owenvallis/chronome/Enclosure/README.rtf

Enclosure files based off of the Machine Collective design. These versions were created by Jim Murphy, and are meant to be used with a laser cutter. The enclosure will fit any Arduinome using the Bebo boards, or any Chronome board. A few notes about these files:

• Line widths need to be fixed before cutting-- just select all and specify line widths. It'll depend on where you're getting them cut.
• The colors need to be fixed -- just select all and specify stroke color (again, this depends on where you're getting them cut)
• The "this product was made with an educational version of autocad" label can be deleted in illustrator or inkscape
• Some free software to use is Inkscape -- but keep this in mind (SUPER important): It exports .svg files at a different size than what illustrator expects (it exports them at 96 dpi versus illustrator's 72 dpi)-- so the scales will be wrong if you save in Inkscape and open the .svg in illustrator. To fix this, you can scale by .85 in illustrator once it's loaded in. What I would recommend is saying fuck it and just using illustrator -- it'll make life a lot easier (and will mean that you're not running the risk of cutting things the wrong size).

Cheers,
Flipmu
