owenvallis/chronome/PCBs V2.2 Atmel Files/ChronomeV2.2/Schematic and Cad Files/ChronomeV2_2_Page_2.png

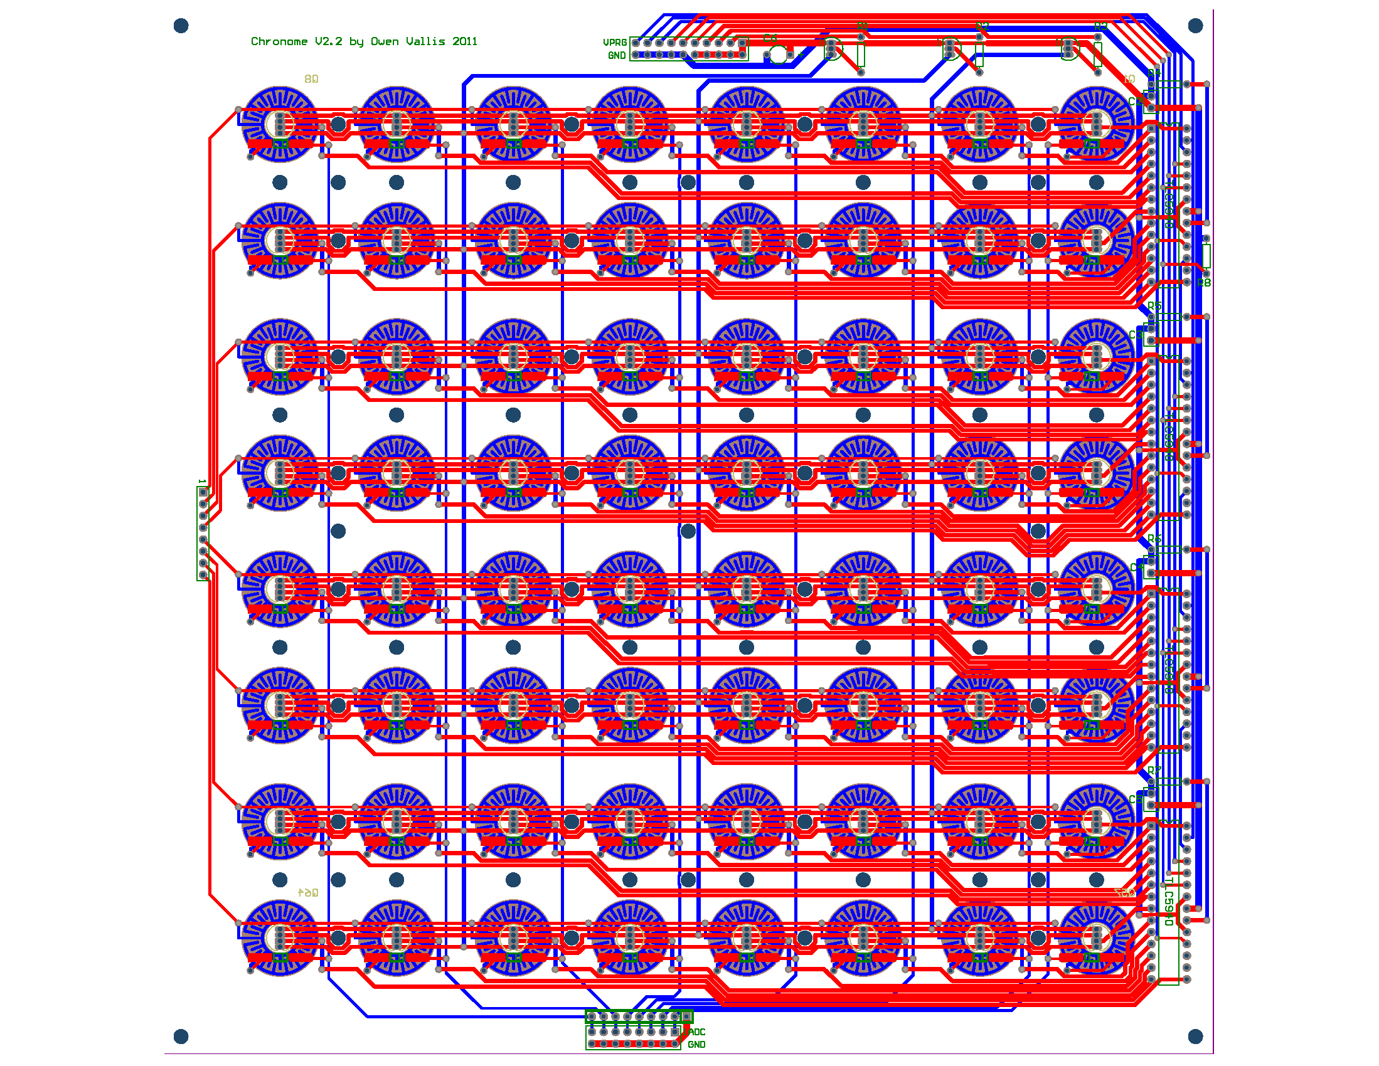
PCBs V2.2 Atmel Files/ChronomeV2.2/Schematic and Cad Files/ChronomeV2_2_Page_2.png
