owenvallis/chronome/PCBs V2.2 Atmel Files/MEGA Shield/Schematic and Cad Files/Mega Shield_Page_2.png

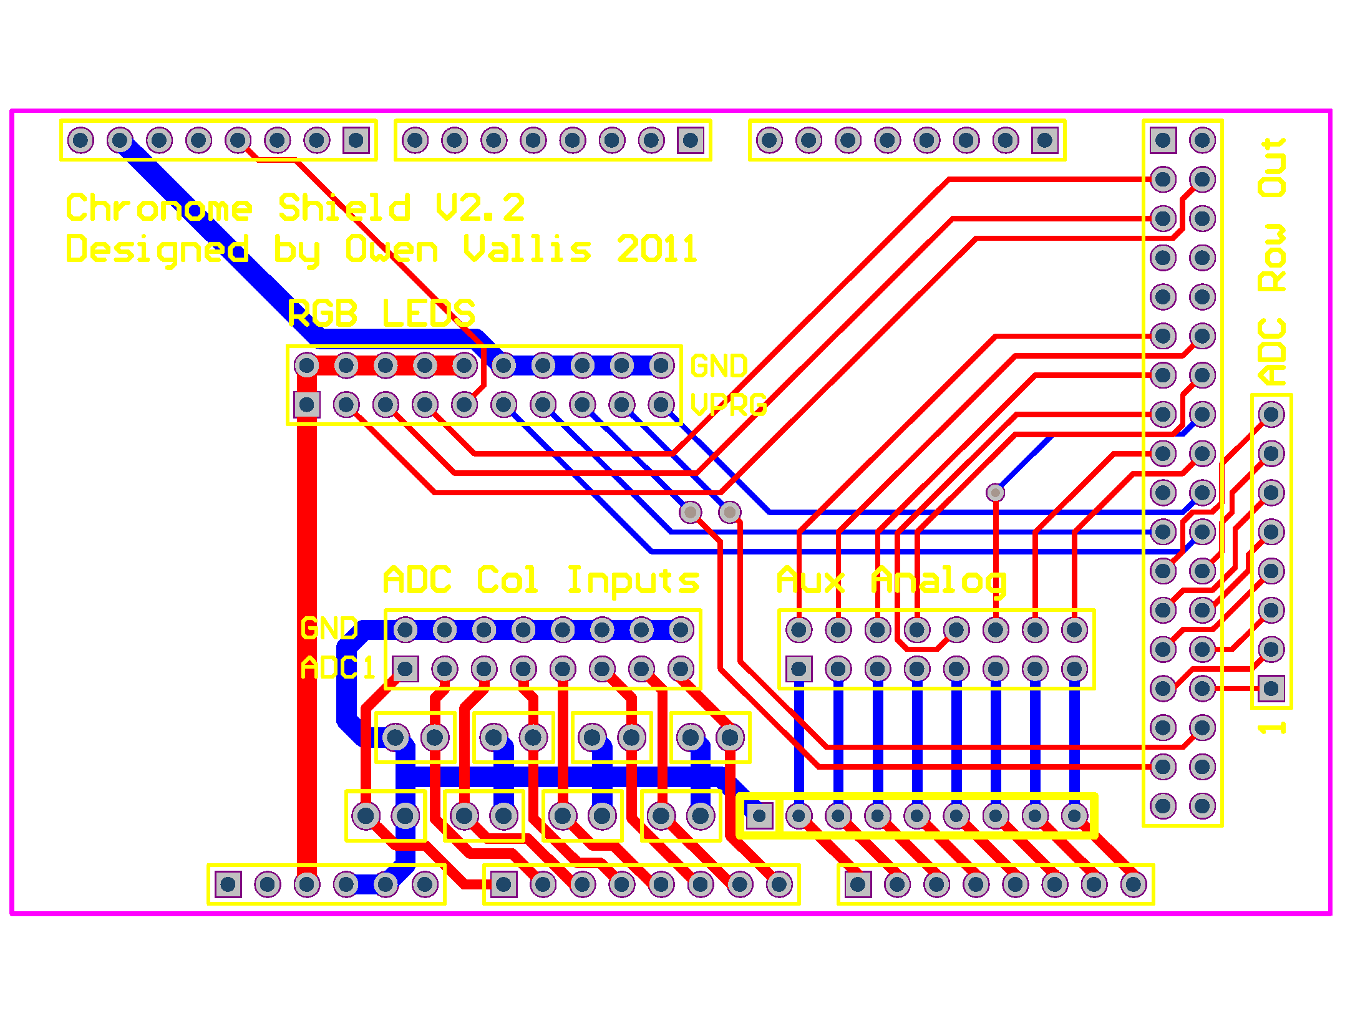
PCBs V2.2 Atmel Files/MEGA Shield/Schematic and Cad Files/Mega Shield_Page_2.png
