owenvallis/chronome/Parts BOM/Parts For Chronome.pdf

Chronome Parts List

SparkFun | | | #VALUE!
Quantity | Description | Unit Price | Total
1 | $64.95 | $64.95
4 | $9.95 | $39.80
70 | $0.14 | $9.80
1 | $59.95 | $59.95
4 | $5.95 | $23.80
4 | $1.50 | $6.00
4 | $0.25 | $1.00
5 | $2.50 | $12.50
| | Total | $217.80
Quantity | Description | Unit Price | Total
2 | $2.02 | $4.04
2 | $1.93 | $3.86
2 | $0.46 | $0.92
1 | $0.53 | $0.53
1 | $0.58 | $0.58
1 | $1.30 | $1.30
1 | $2.07 | $2.07
1 | $2.59 | $2.59
3 | $0.14 | $0.42
4 | $0.09 | $0.36
1 | $0.09 | $0.09
3 | $0.49 | $3.49
Total | $20.25
Project Total | | | $238.05

Arduino Mega Board (http://www.sparkfun.com/products/9949)
Button Pad 4x4 - LED Compatible (http://www.sparkfun.com/products/7835)
Diode Small Signal - 1N4148 (http://www.sparkfun.com/products/8588)
Triple Output LED RGB - Diffused - 100pcs (http://www.sparkfun.com/products/10017) TLC 5940 - PWM Driver (http://www.sparkfun.com/products/10136)
DIP Sockets Solder Tail - 28-Pin 0.3" (http://www.sparkfun.com/products/7942) Capacitor Ceramic 0.1uF (http://www.sparkfun.com/products/8375)
Break Away Headers - Straight (http://www.sparkfun.com/products/116)

DigiKey

CONN IDC SOCKET 20POS 15 GOLD (http://search.digikey.com/scripts/DkSearch/dksus.dll?WT.z_header=search_go&lang=en&site=us&x=0&y=0) CONN IDC SOCKET 16POS 15 GOLD (http://search.digikey.com/scripts/DkSearch/dksus.dll?WT.z_header=search_go&lang=en&site=us&x=0&y=0) CONN RECEPT 8POS 26AWG MTA100 (http://search.digikey.com/scripts/DkSearch/dksus.dll?Detail&name=A30992-ND) CAP ALUM 470UF 25V 20% RADIAL (http://search.digikey.com/us/en/products/UPW1E471MPD6/493-1827-ND/589568) RES NET 9RES 10K OHM 10PIN (http://search.digikey.com/scripts/DkSearch/dksus.dll?Detail&name=770-101-R10KP-ND) CABLE 9 COND 5' GRAY RIBBON (http://search.digikey.com/scripts/DkSearch/dksus.dll?Detail&name=AE09G-5-ND) CABLE 16 COND 5' GRAY RIBBON (http://search.digikey.com/scripts/DkSearch/dksus.dll?vendor=0&keywords=AE16G-5-) CABLE 20 COND 5' GRAY RIBBON (http://search.digikey.com/scripts/DkSearch/dksus.dll?vendor=0&keywords=AE20G-5-ND) RES 1.0K OHM CARBON FILM 1/2W 5% (http://search.digikey.com/scripts/DkSearch/dksus.dll?Detail&name=P1.0KBBCT-ND) RES 6.2K OHM CARBON FILM 1/4W 5% (http://search.digikey.com/scripts/DkSearch/dksus.dll?Detail&name=P6.2KBACT-ND) RES 10K OHM CARBON FILM 1/4W 5% (http://search.digikey.com/us/en/products/CFR-25JB-10K/10KQBK-ND/338) TRANSISTOR AMP PNP SS GP TO-92 (http://search.digikey.com/scripts/DkSearch/dksus.dll?lang=en&site=US&KeyWords=PN2907ABUFS-ND&x=0&y=0)
