owenvallis/chronome/PCBs V2.2 Atmel Files/MEGA Shield/Schematic and Cad Files/Mega Shield.pdf

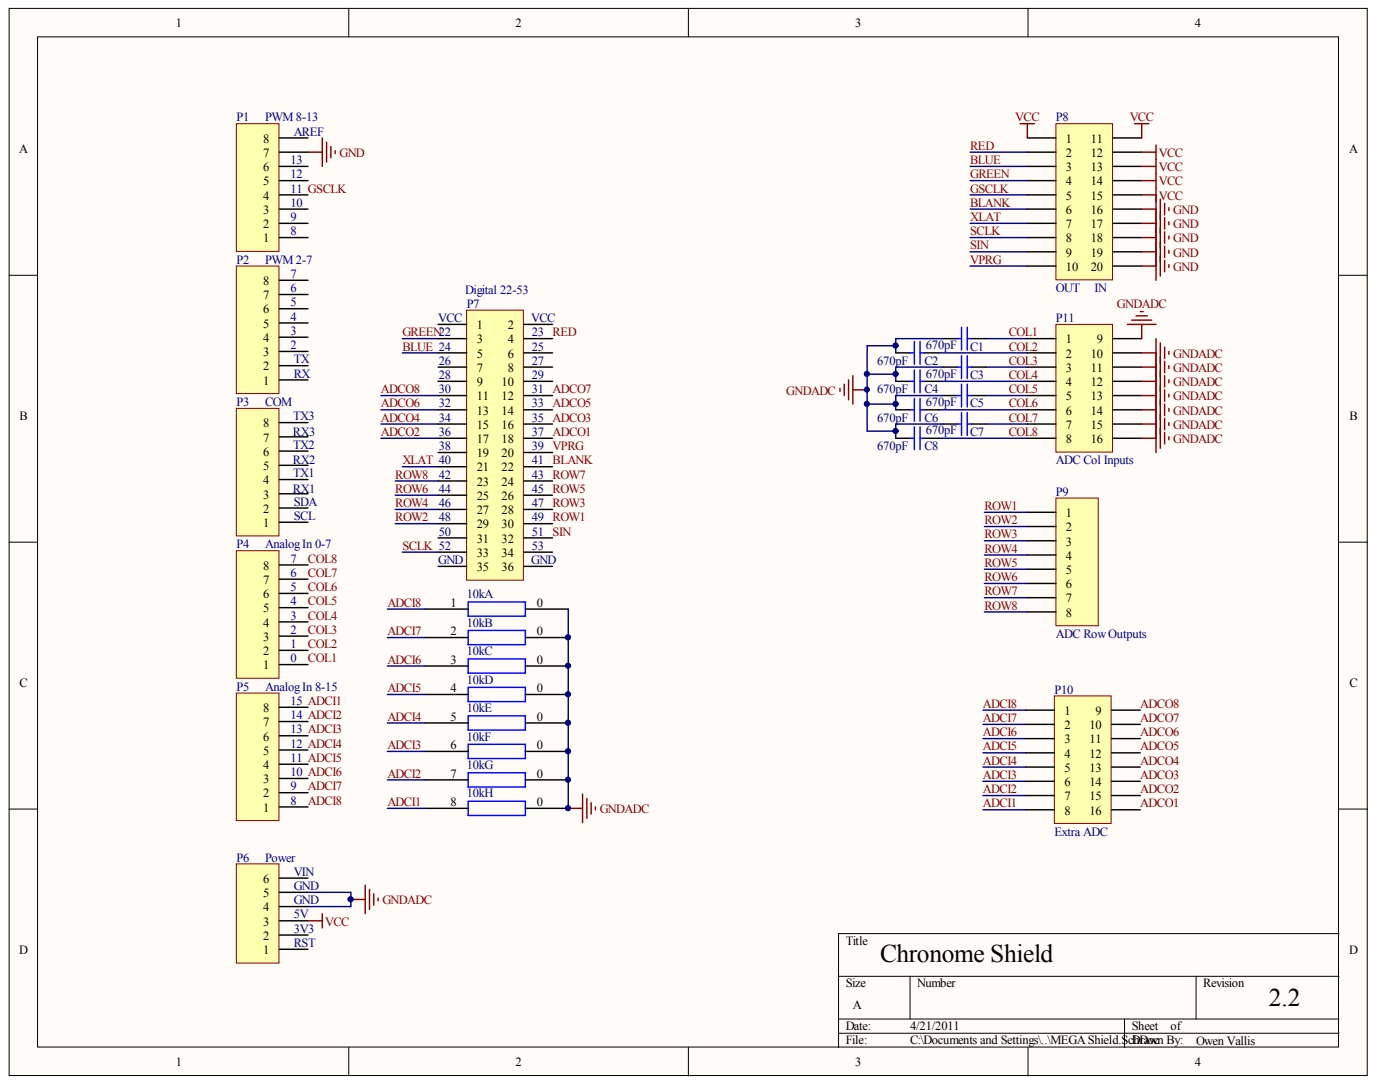
[picture p5: page 1]

LUE GREEN GSCLK BLANK XLAT SCLK SINVPRG

GND GND 5V3V3 VIN AREF 8910111213234567TXRXSCL SDA RX1 RX2 RX3 TX1 TX2 TX3
CGND

p F | C 2 | C OL 3 | | uts GNDAD

6 7 0 | p F | C 3 C OL4
p F | C 4 | | C OL 5
6 7 0 | p F | C 5 C OL 6

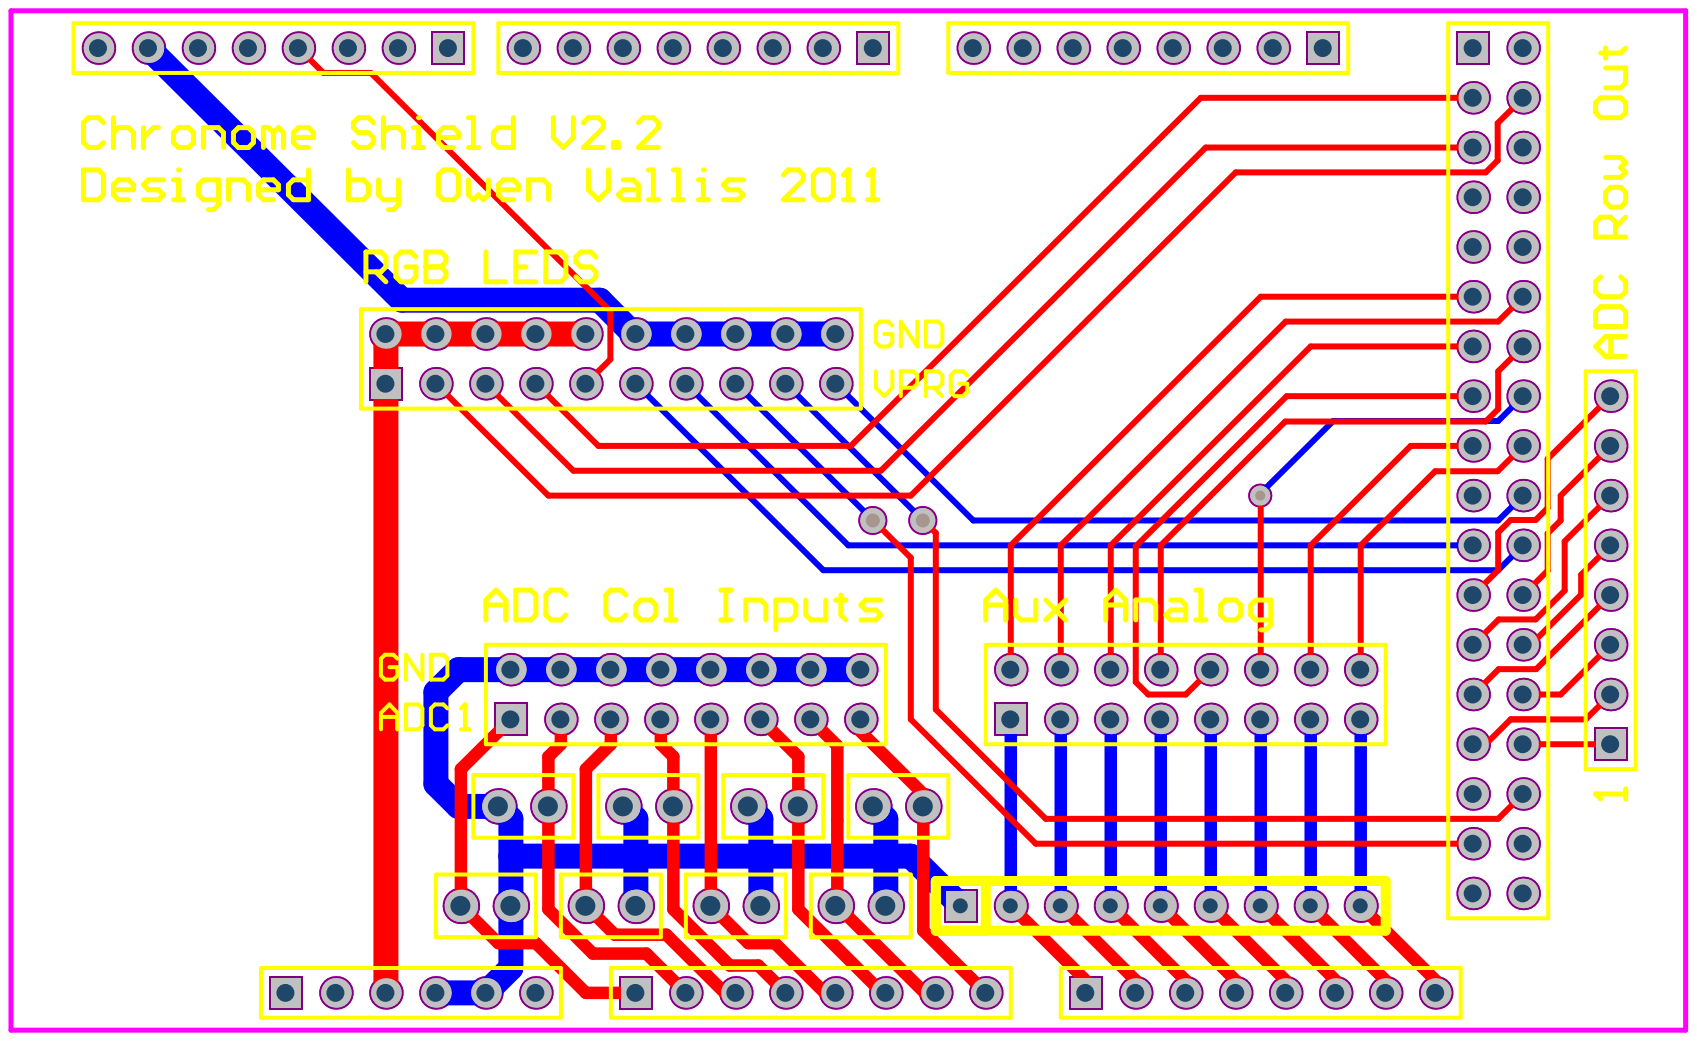
[picture p6: page 2]
