owenvallis/chronome/Button Pad Gerber Files/ChronomeV2.pdf

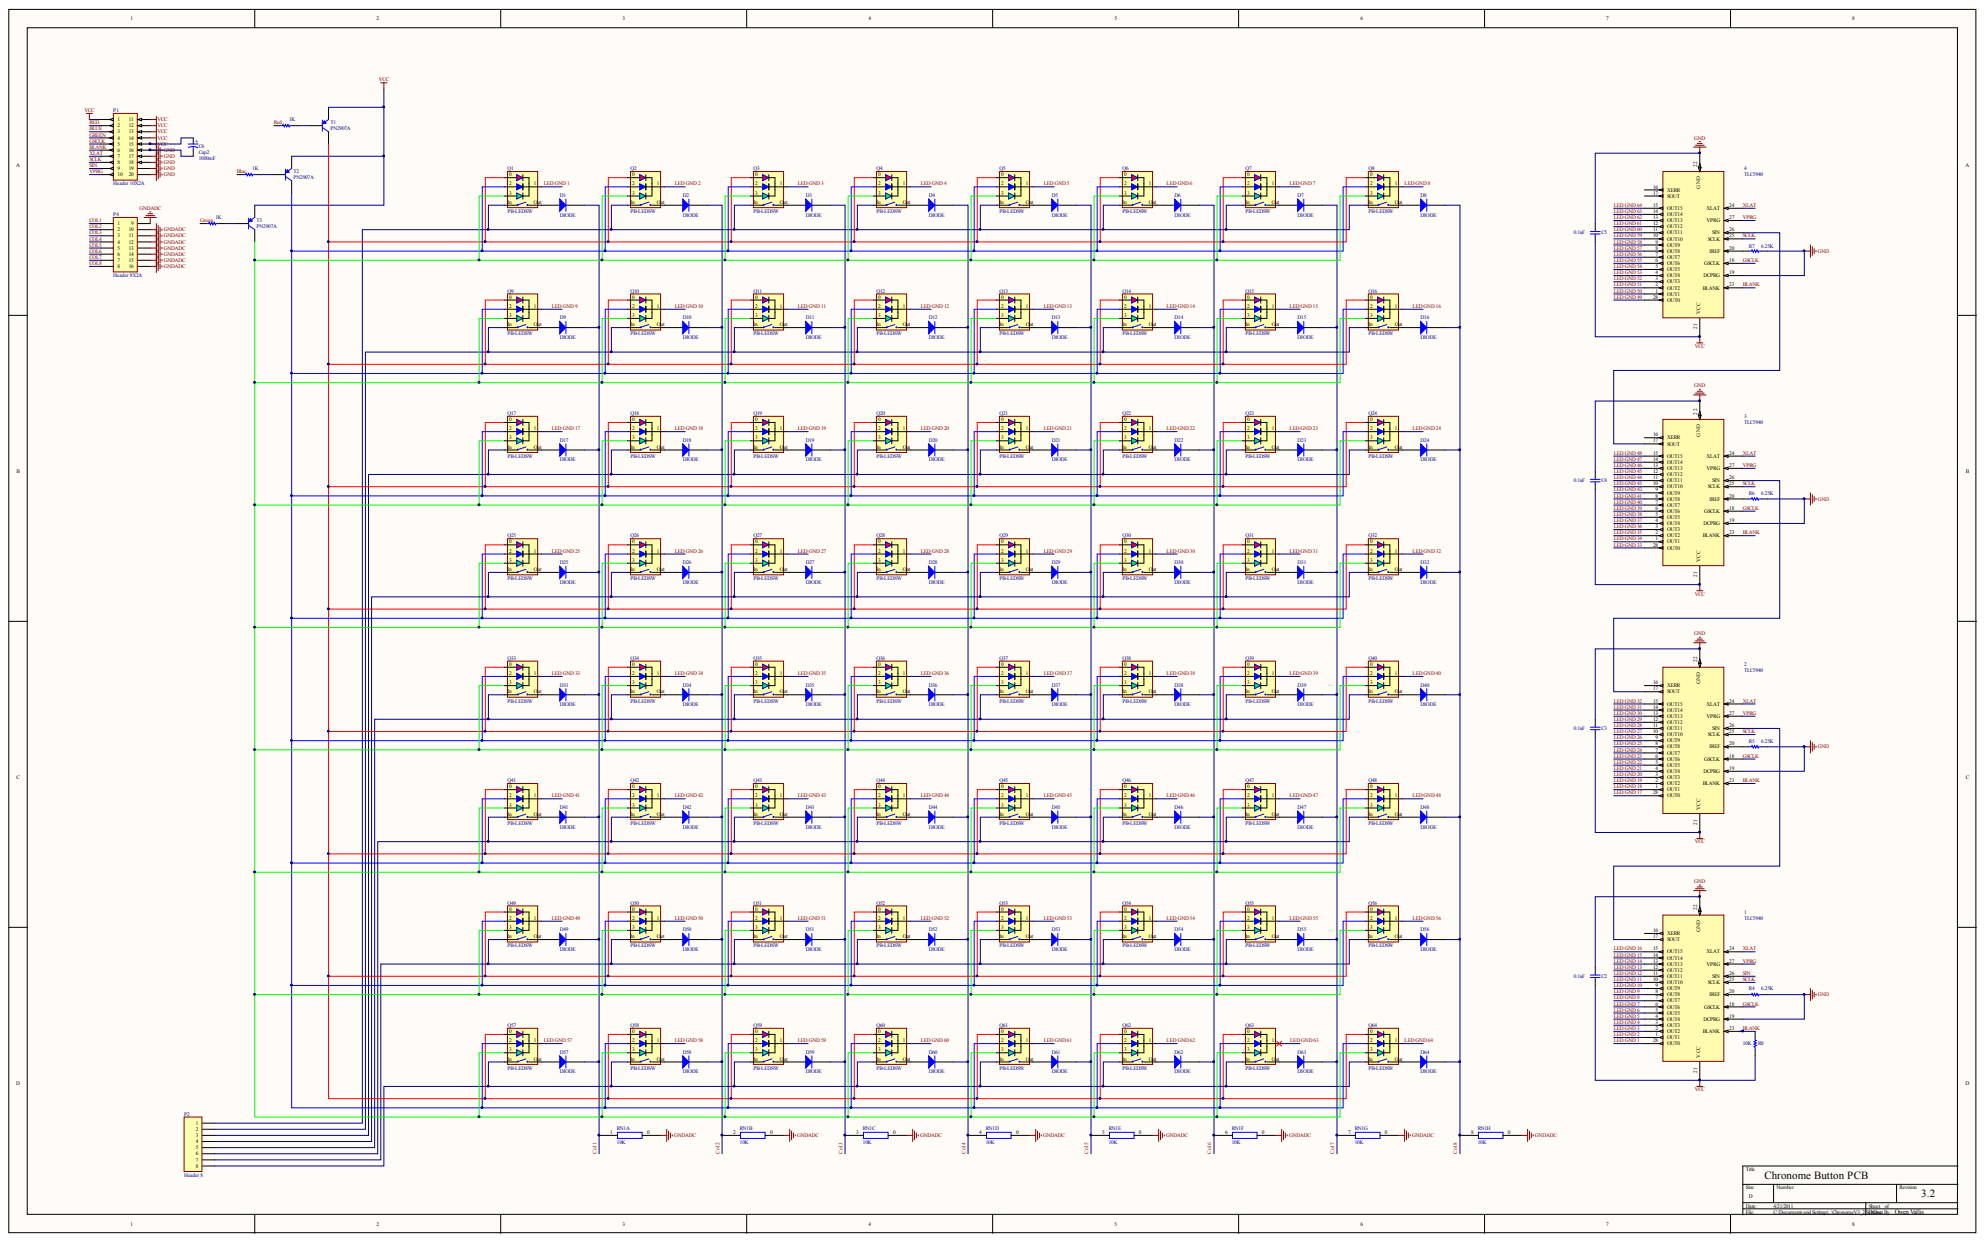
[picture p7: page 1]

RED BLUE GREEN SCLK XLAT SINGSCLK VPRG BLANK COL1 COL2 COL3 COL4 COL5 COL6 COL7 COL8

GND GND

SCLK SCLK SCLK SCLK XLAT XLAT XLAT XLAT SINGSCLK GSCLK GSCLK GSCLK R4

Size DDate | Num b e r | Re vi s i on 3. 2

: 4/2 1 /2 0 1 1 | She e t o f
Fi l e : C : \D o c um e nts a nd Se tting s\ . . \Chro nom e V 3 _2 | . ScDhraDwocn By : Owen Vallis

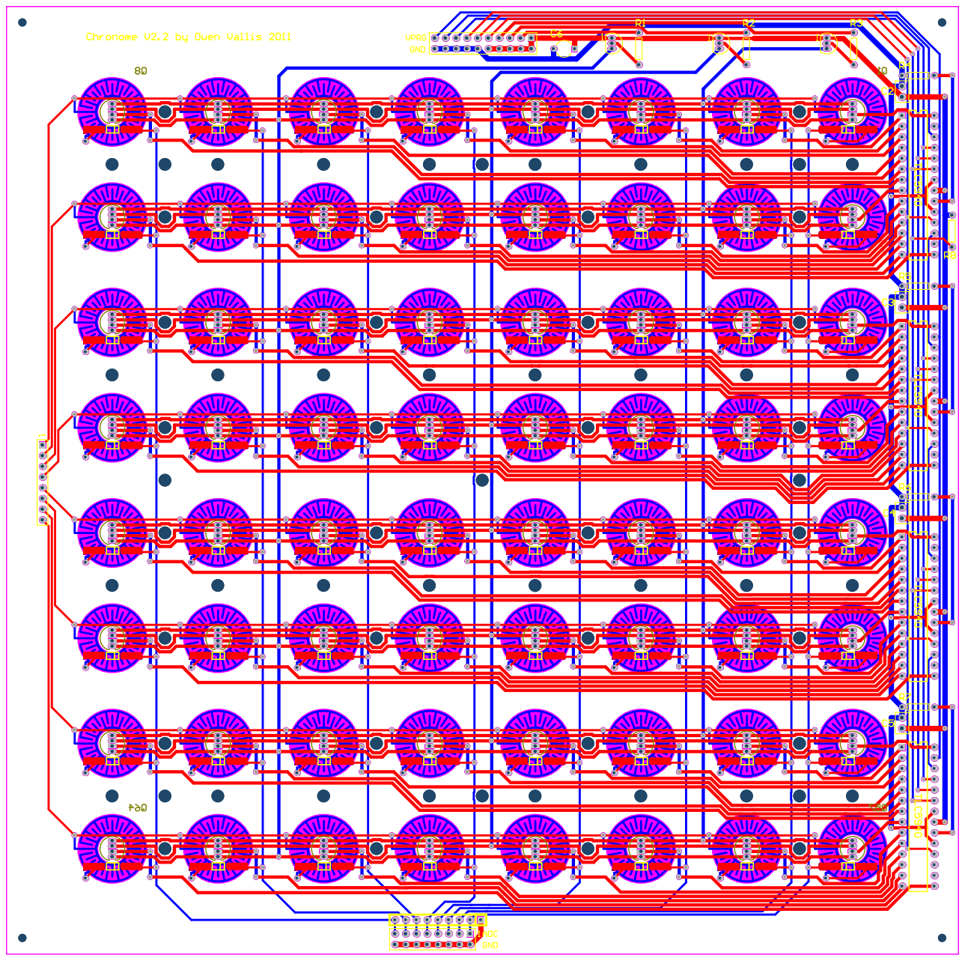
[picture p8: page 2]
