owenvallis/chronome/PCBs V2.2 Atmel Files/ChronomeV2.2/Schematic and Cad Files/ChronomeV2_2.pdf

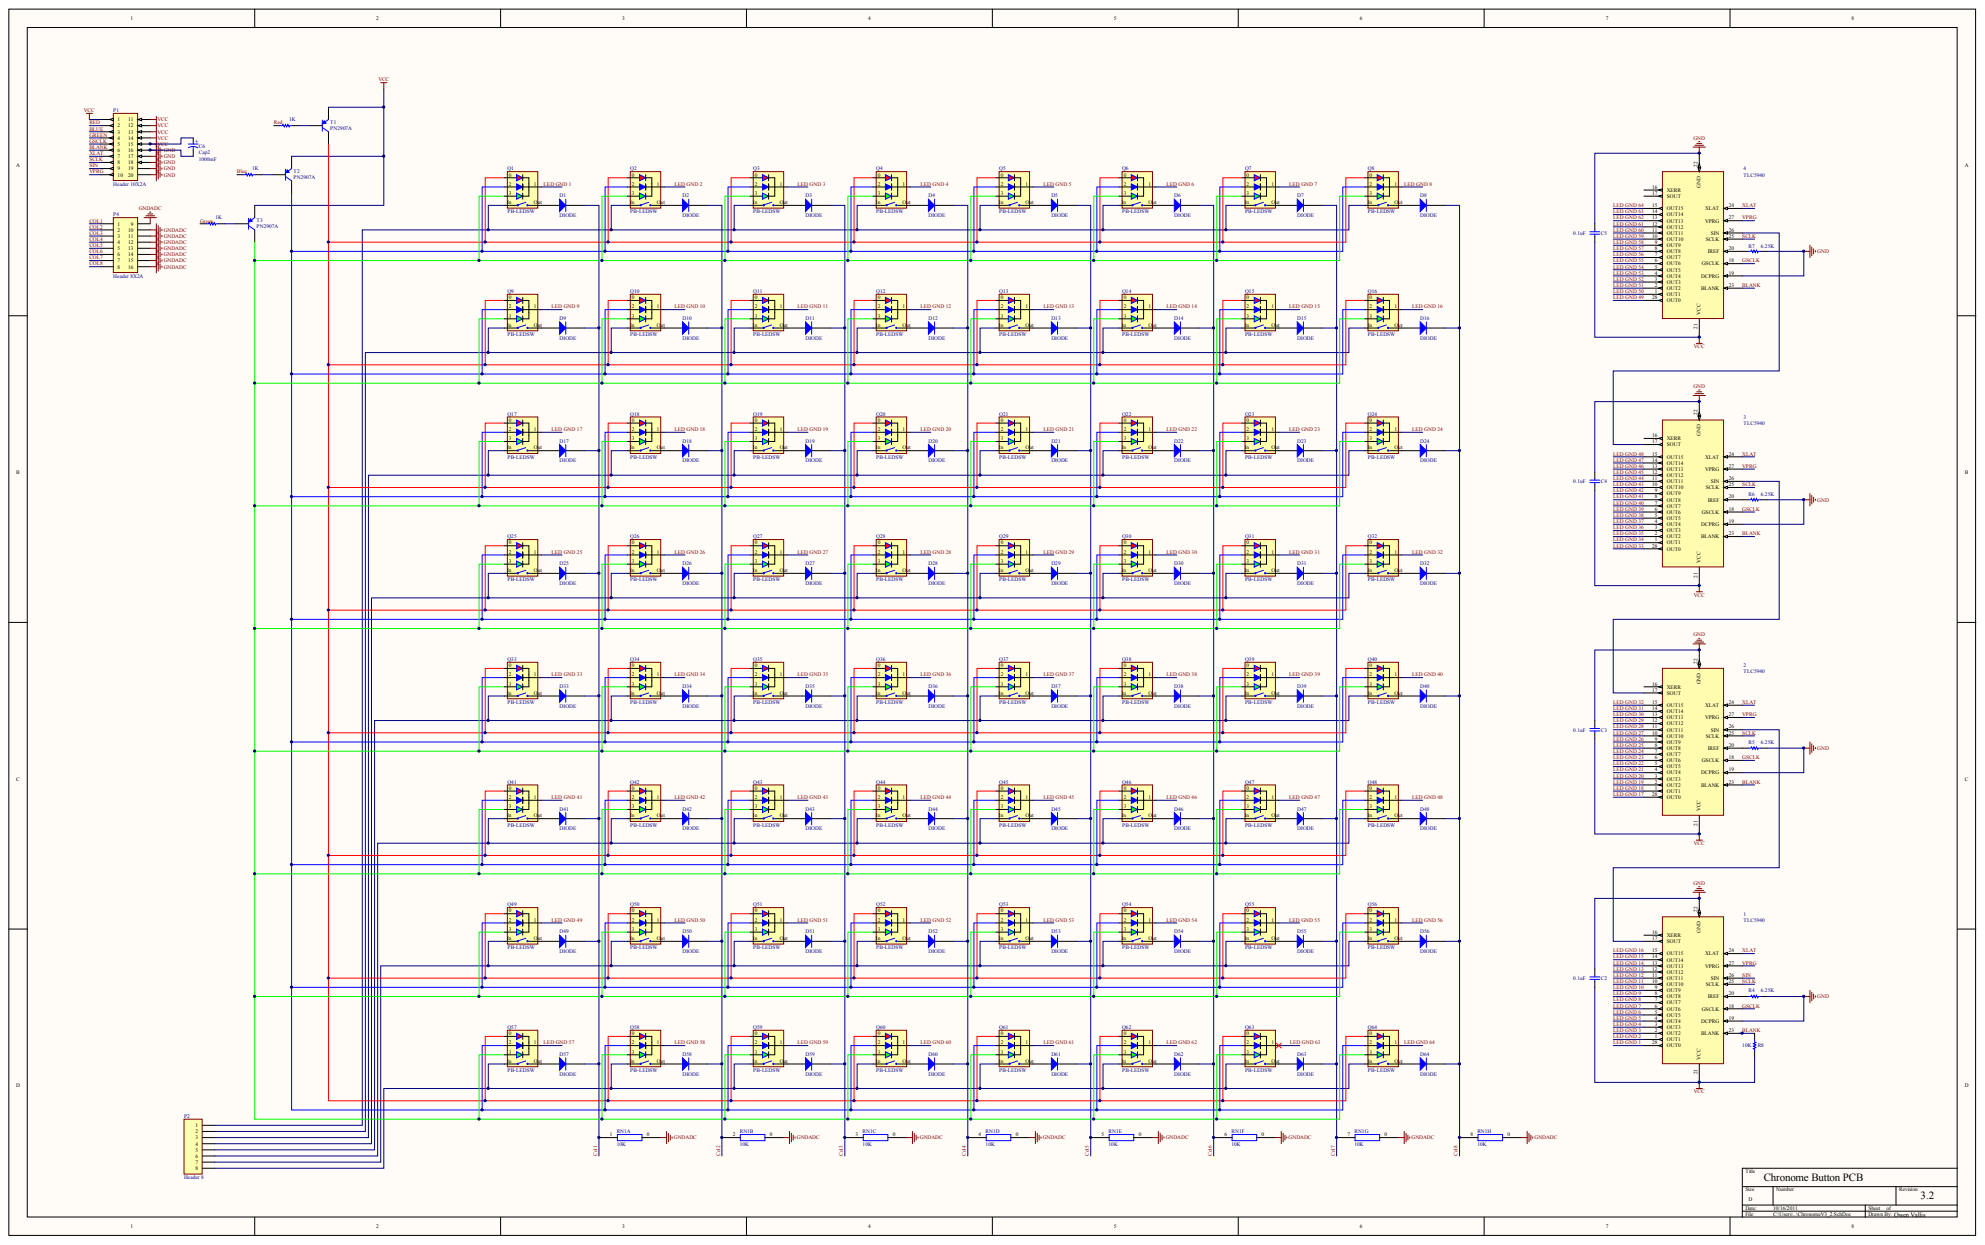
[picture p9: page 1]

VCC VCC VCC VCC VCC

XLA
VPRG VPRG

VCC VCC

Size D | Number | Rev ision 3.2

Date: 10/16/2011 | Sheet o f
Fi le: C:\Users\. .\Chronome V3_2 . SchDoc | Drawn By: O w e n V allis

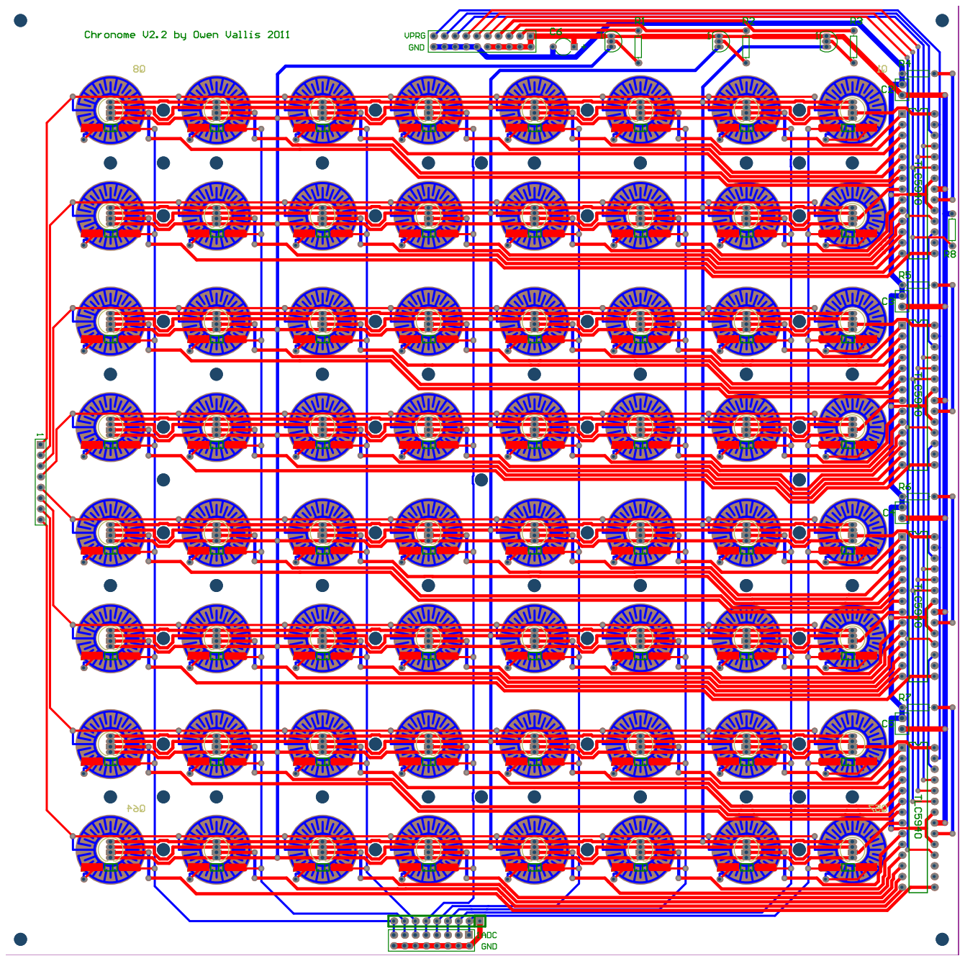
[picture p10: page 2]
