owenvallis/chronome/Enclosure/Chronome_NoWood1.pdf

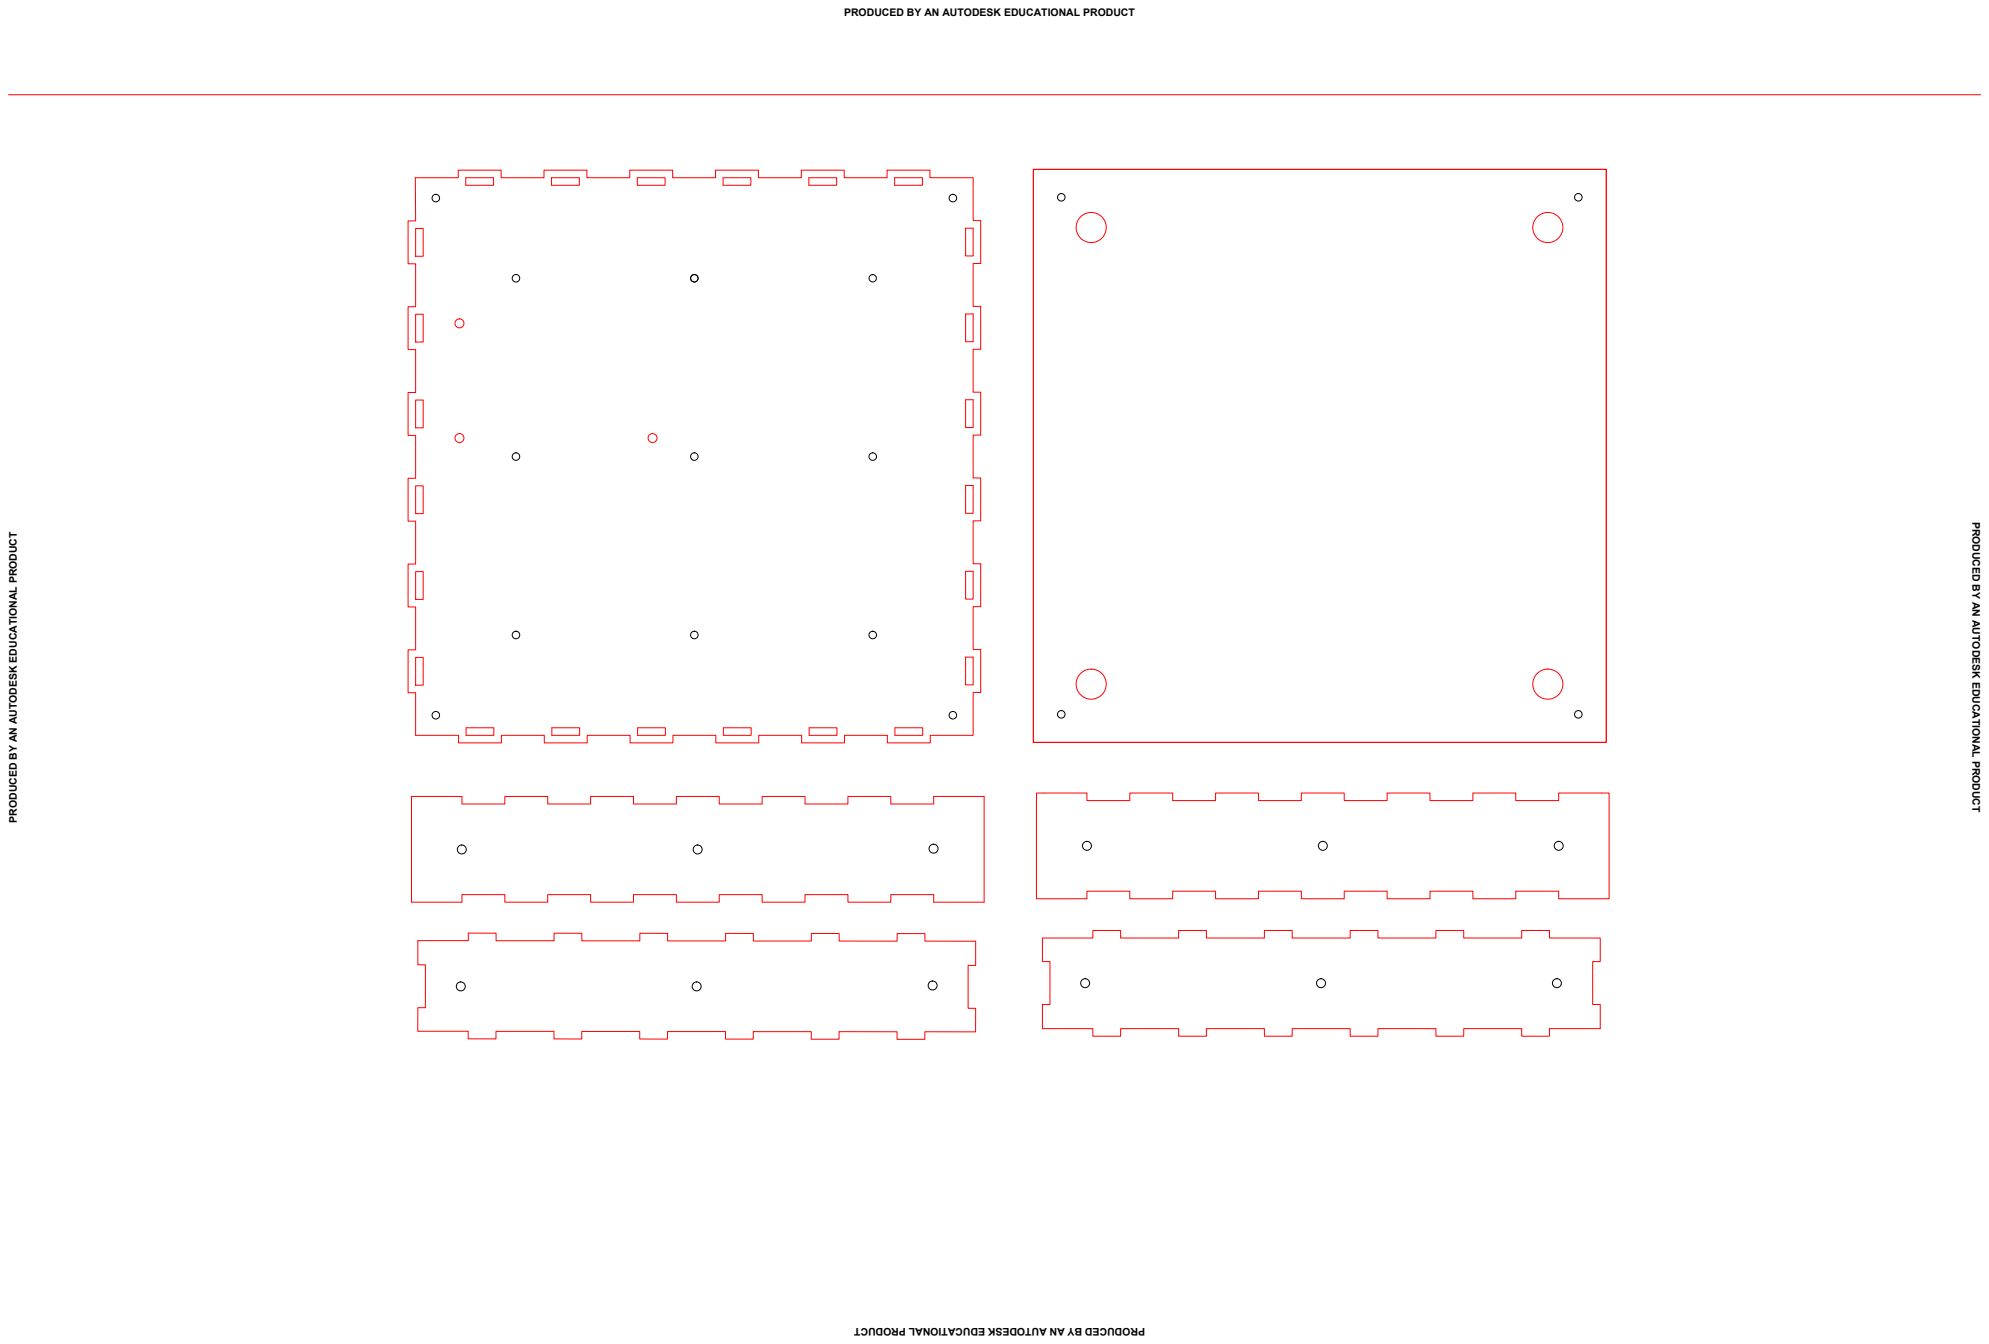
[picture p11: page 1]

PRODUCED BY AN AUTODESK EDUCATIONAL PRODUCT
