owenvallis/chronome/Enclosure/Chronome_NoWood2.pdf

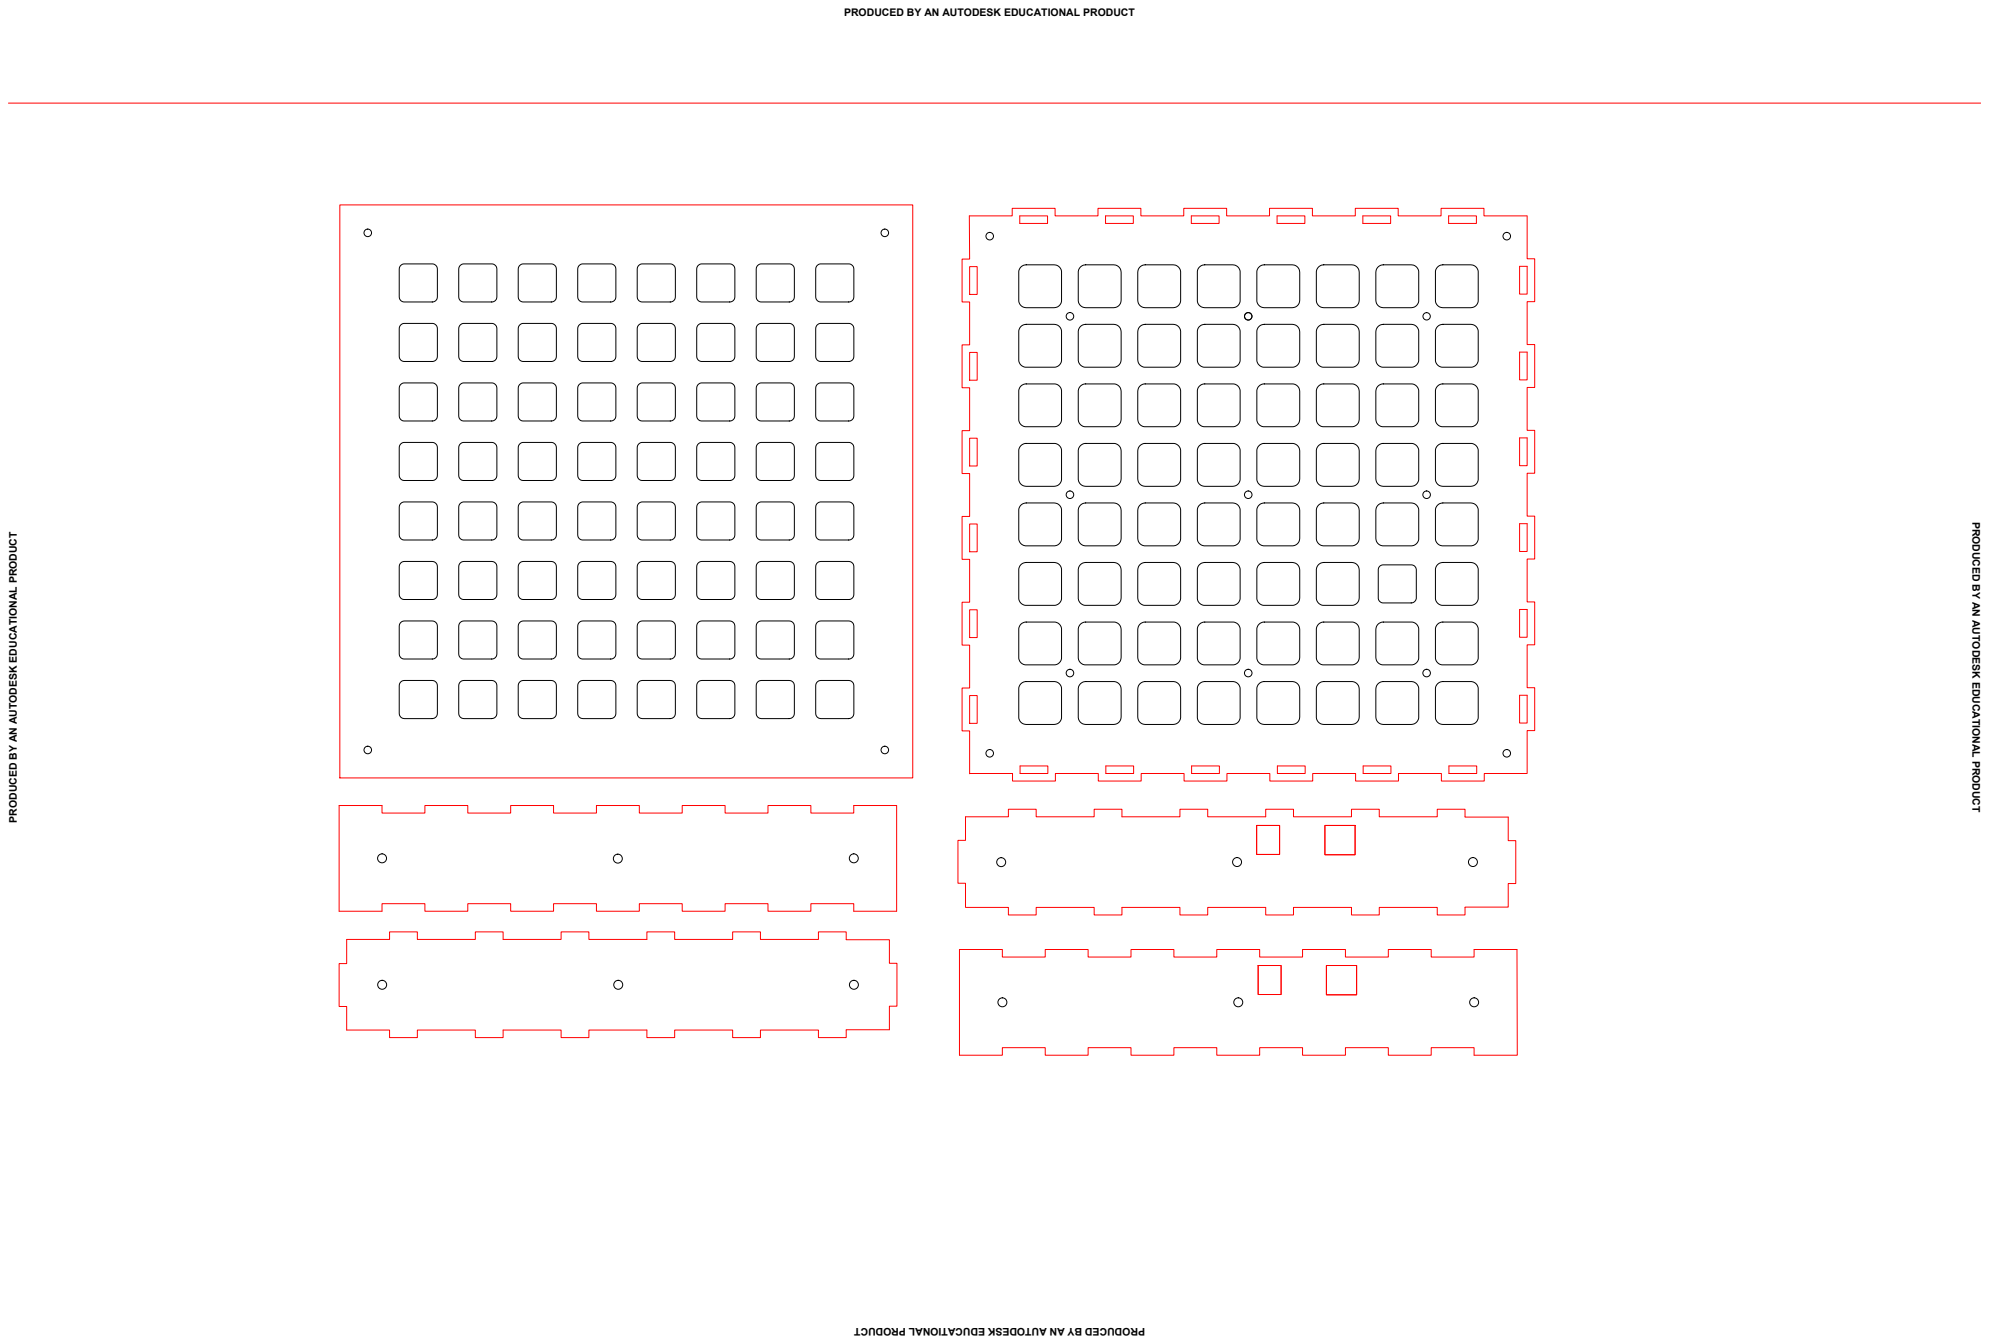
[picture p12: page 1]

PRODUCED BY AN AUTODESK EDUCATIONAL PRODUCT
