owenvallis/chronome/Enclosure/WOODSIDEChronome_enclosure1.pdf

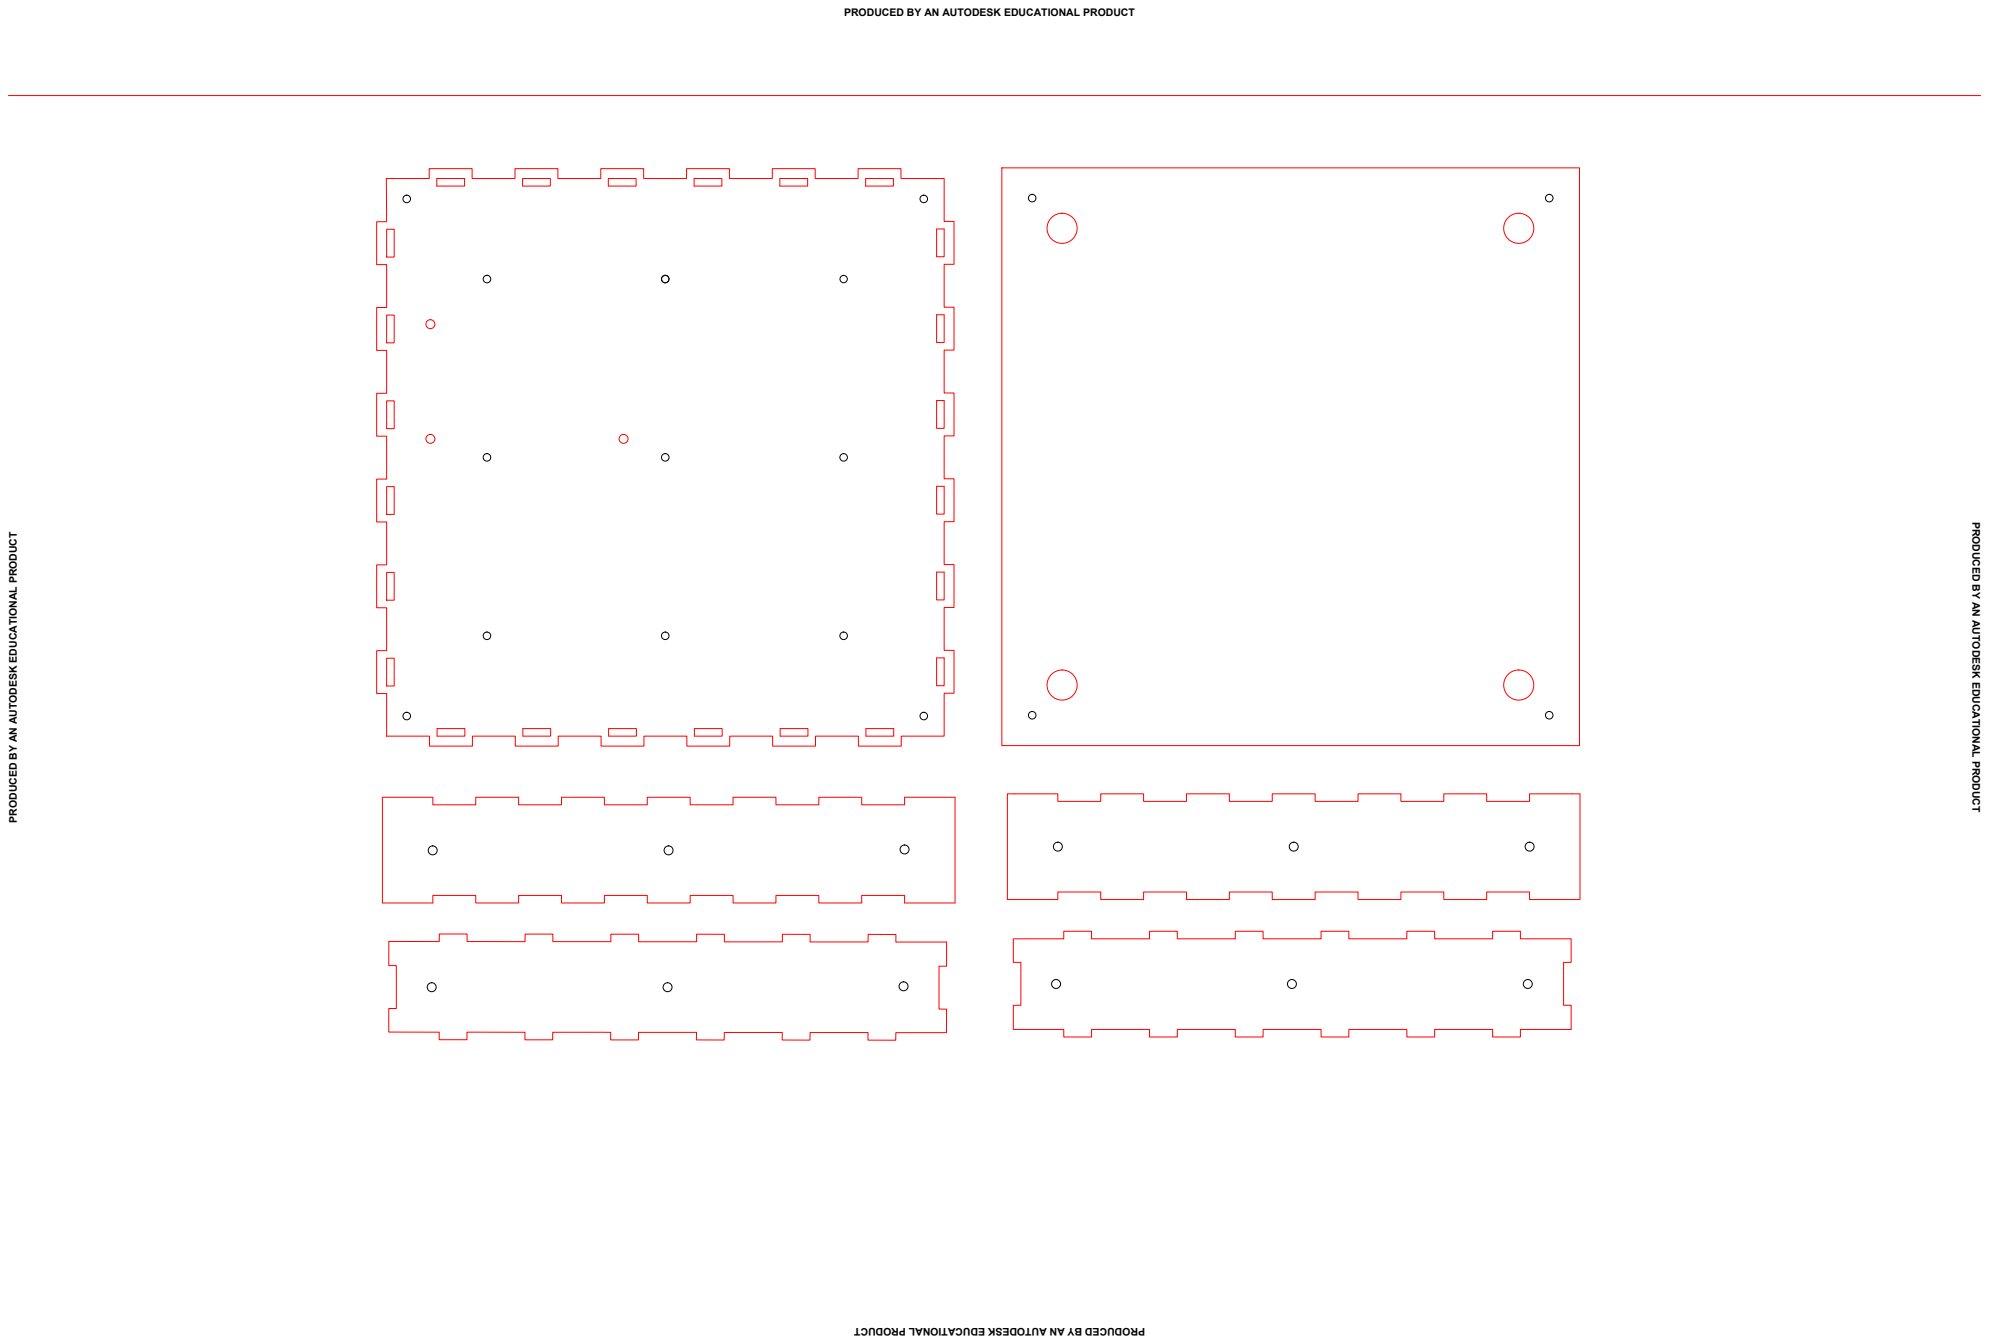
[picture p13: page 1]

PRODUCED BY AN AUTODESK EDUCATIONAL PRODUCT
