owenvallis/chronome/Enclosure/WOODSIDEChronome_enclosure2.pdf

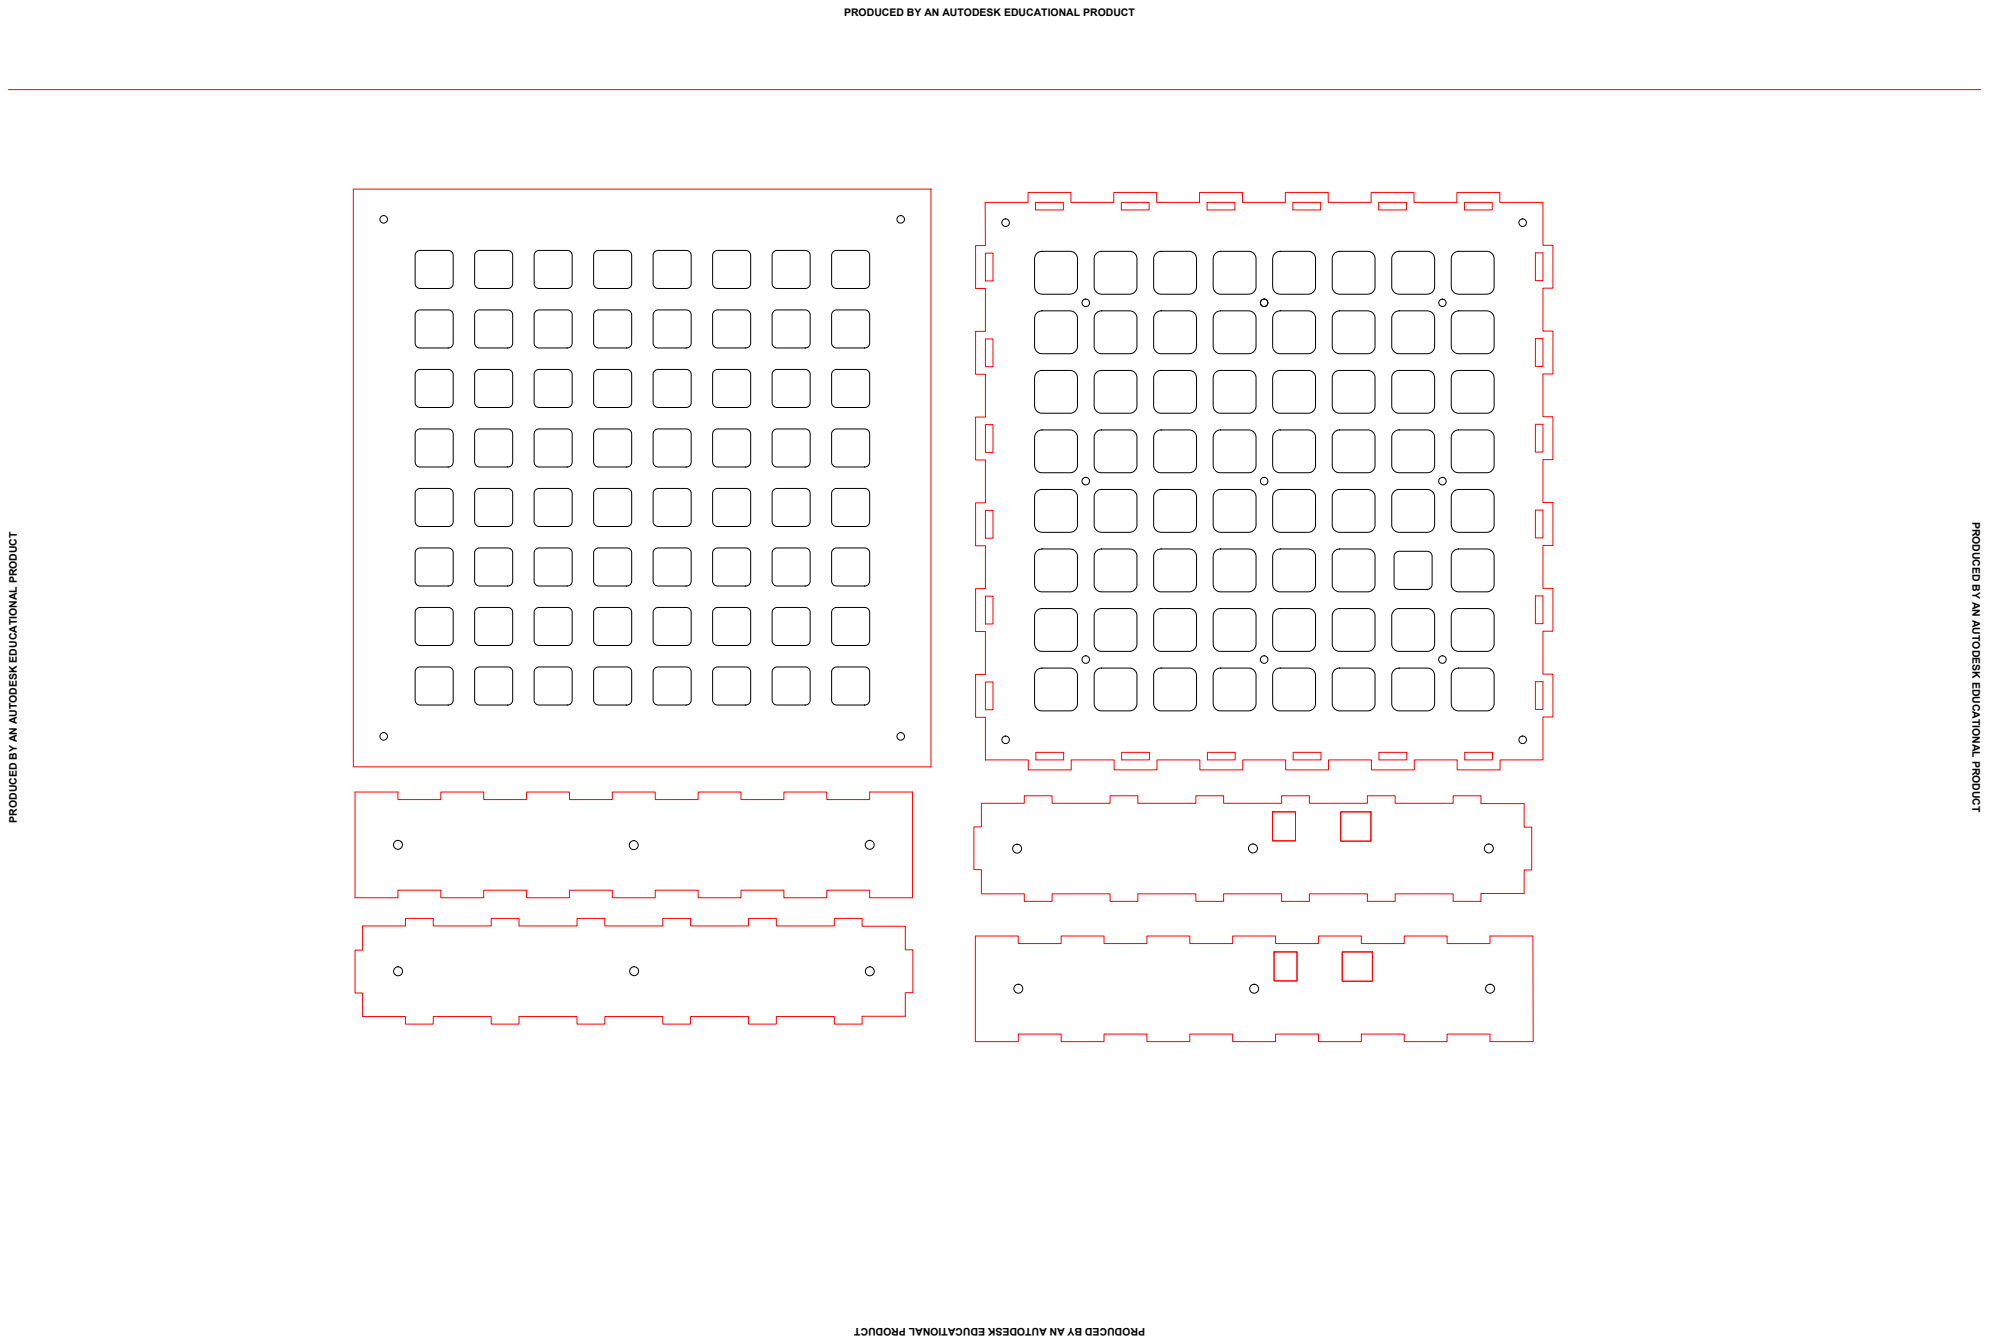
[picture p14: page 1]

PRODUCED BY AN AUTODESK EDUCATIONAL PRODUCT
