owenvallis/chronome/(list of files, drawings)

Other design files:
PCBs V2.2 Atmel Files/ChronomeV2.2/ChronomePCBV2_2.PcbDoc
PCBs V2.2 Atmel Files/ChronomeV2.2/ChronomeV2_2.PrjPcb
PCBs V2.2 Atmel Files/ChronomeV2.2/ChronomeV3_2.SchDoc
PCBs V2.2 Atmel Files/ChronomeV2.2/Older Version/ChronomePCBV2.PcbDoc
PCBs V2.2 Atmel Files/MEGA Shield/History/MEGA Shield.~(33).PcbDoc
PCBs V2.2 Atmel Files/MEGA Shield/MEGA Shield.PcbDoc
PCBs V2.2 Atmel Files/MEGA Shield/Mega Shield.PrjPcb
PCBs V2.2 Atmel Files/MEGA Shield/MEGA Shield.SchDoc
