owenvallis/chronome/(notices)

Notices in the files:
Firmware/CHRONOME_Beta_013/CHRONOME_Beta_013.ino:
This program is free software; you can redistribute it and/or modify
it under the terms of the GNU General Public License as published by
the Free Software Foundation; either version 2 of the License, or
(at your option) any later version.
Copyright 2010 Matthew T. Pandina. All rights reserved.
